medo64/CanStick/Hardware/Board/CanStick-Jack [B].md

### CanStick/Jack ###

Board size: 105.8 x 26.0 mm ~ 4.3 sqin
Panel size: 29.5 x 20.3 mm ~ 1.0 sqin (2x)

#### Input ####

Voltage: 5 V ±10%
Current: 150 mA (max)

#### Parts ####

|  # | Part | RefDes  | Digi-Key Part Number | Alternate Part Number |
|---:|---|---|---|---|
|  2 | C 22pF 16V NP0 (0603) | C1 C2 | 478-1167-1-ND | |
|  1 | C 10nF 16V NP0 (0805) | C3 | 1276-2984-1-ND | |
|  5 | C 100nF 35V X7R (0805) | C4-C8 | 399-1170-1-ND | |
|  4 | C 10uF 16V X5R (0805) | C9-C12  | 399-8013-1-ND | |
|  1 | D PESD1CAN-UX (SOT23-3) | D1 | 568-4032-1-ND | |
|  6 | DS LED (0805) | DS1-DS6 | 475-1415-1-ND | |
|  1 | J USB B, horizontal | J1 | ED2982-ND | |
|  1 | J RJ-45 (56) LED | J2 | RJHSE-5381-ND | |
|  1 | L Ferrite 40Ohm (0805) | L1 | 445-2201-1-ND | |
|  2 | R 120 0.5W (1206) † | R1 R2 | P120ALCT-ND | |
|  5 | R 330 0.125W (0805) | R3-R7 | RMCF0805FT330RCT-ND | |
|  3 | R 1K 0.125W (0805) | R8-R10  | RMCF0805FT1K00CT-ND | |
|  1 | U FT232RL (SSOP-28) | U1 | 768-1007-1-ND | |
|  1 | U PIC18F25K80 (SSOP-28) | U2 | PIC18F25K80-I/SS-ND | |
|  1 | U ISO1050 (SOP-8) | U3 | 296-24818-1-ND | |
|  1 | VR DC-DC 5V->5V 1W (SIP-4) | VR1 | 945-1655-5-ND | |
|  1 | Y Crystal 12MHz 50ppm 20pF | Y1 | 887-2011-ND | 887-1238-ND |
|  1 | H Enclosure 1593DBK | | HM861-ND | |

† Optional termination resistor
