medo64/CanStick/(list of files, drawings)

Other design files:
Hardware/Board/CanStick [B] PanelBack.dip
Hardware/Board/CanStick [B] PanelFront.dip
Hardware/Board/CanStick [B].dip
Hardware/Board/CanStick-Jack [B] PanelBack.dip
Hardware/Board/CanStick-Jack [B] PanelFront.dip
Hardware/Board/CanStick-Jack [B].dip
Hardware/Board/CanStick-Mini [C].dip
