medo64/CanStick/Firmware/Source/config.h

#ifndef CONFIG_H
#define CONFIG_H

#if defined(CANSTICK) == defined(DEVICE_CANJACK)
    #error Must select either CanStick or CanJack device configuration.
#endif


#define _XTAL_FREQ 48000000

void init(void);
void wait_short(void);
void reset(void);

#endif
