medo64/CanStick/(commit log)

2014-03-24 Initial commit.
    [UsbCan [A].dip]
2014-04-09 Refactoring to have all components on top.
    [UsbCan [A].dip]
2014-04-14 Added UART LED.
    [UsbCan [A].dip]
2014-04-14 Added test points.
    [UsbCan [A].dip]
2014-04-14 Added USB power test pads.
    [UsbCan [A].dip]
2014-04-17 Moving U2 label.
    [UsbCan [A].dip]
2014-04-19 Added two more test points.
    [UsbCan [A].dip]
2014-04-19 Renamed project to CanStick.
    [CanStick [A].dip, UsbCan [A].dip]
2014-04-19 Rotated test pads.
    [CanStick [A].dip]
2014-04-30 Changing capacitor type.
2014-05-01 Initial firmware (CAN is not working yet).
    [app.c, config.c, config.h, uart.c, uart.h]
2014-05-01 Changing silk screen.
    [CanStick [A].dip]
2014-05-02 Fixed pull-up MOSFET error.
    [CanStick [A].dip]
2014-05-13 Connected STBY to GND.
    [CanStick [A].dip]
2014-05-13 Initial working CAN TX.
    [SpeedCalc.xlsx]
2014-05-14 Updated formulas.
    [SpeedCalc.xlsx]
2014-05-15 Refactoring so that FTDI can use same crystal as PIC.
    [CanStick [A].dip]
2014-05-16 Adding length into calculations.
    [CanBusSpeed.xlsx, SpeedCalc.xlsx]
2014-05-16 Added oscillator tolerance.
    [CanBusSpeed.xlsx]
2014-05-18 Added diode to prevent CAN voltage keeping device on.
    [CanStick [A].dip]
2014-05-18 Added RTS/CTS data lines.
    [CanStick [A].dip]
2014-05-18 Refactoring UART code.
2014-05-18 Return alone doesn't cause error.
    [app.c]
2014-05-18 Added CAN status command and code doesn't block if CAN TX is passive/off.
    [app.c, can.h]
2014-05-22 Refactoring and changing dim resistors a bit.
    [CanStick [A].dip]
2014-06-14 Updating for adjusted HW design.
    [CanBusSpeed.xlsx]
2014-06-15 Updated silk screen.
    [CanStick [A].dip]
2014-07-03 Changed diode to Shottky.
    [CanStick [A].dip]
2014-11-02 Replaced FT232R with MCP2221.
    [CanStick [A].dip, CanStick [B].dip]
2014-11-02 Filled copper pours.
    [CanStick [B].dip]
2014-11-12 Changed capacitor to cheaper model.
2015-05-27 Added CanJack board.
    [CanJack PanelBack [A].dip, CanJack PanelFront [A].dip, CanJack [A].dip, CanStick [B].dip]
2015-06-07 Corrected resistor DigiKey code.
2015-11-06 Initial commit of CanBlock.
    [CanBlock PanelBack [A].dip, CanBlock PanelFront [A].dip, CanBlock [A].dip]
2016-05-16 Refactoring board.
    [CanBlock PanelBack [A].dip, CanBlock PanelFront [A].dip, CanBlock [A].dip, CanJack PanelBack [A].dip, CanJack PanelFront [A].dip, CanJack [A].dip, CanStick [B] PanelBack.dip, CanStick [B] PanelFront.dip]
2016-05-27 Fixed D1 silk screen.
    [CanStick [B].dip, CanStick-Jack [B].dip]
2016-05-28 Using RA3 to distinguish between CanStick and CanStick/jack.
    [CanStick [B].dip, CanStick-Jack [B].dip, CanStick-Mini [C].dip]
2016-06-06 Added SLCAN support.
    [CanBusSpeed.xlsx]
2016-06-06 Routed shield wire.
    [CanStick-Jack [B].dip]
2016-06-06 Moved activity light to RJ45 connector.
    [CanStick-Jack [B].dip]
2016-07-03 Fixed CAN bus timings.
    [CanBusSpeed.xlsx]
2016-07-04 Adjusting default speeds.
    [CanBusSpeed.xlsx]
2016-07-04 Refactoring and removing unsupported speed (due to high frequency clock).
    [CanBusSpeed.xlsx]
2017-05-28 Changed bear icon.
    [CanStick [B].dip, CanStick-Jack [B].dip, CanStick-Mini [C].dip]
2017-06-03 Changed icon.
    [CanStick [B].dip, CanStick-Jack [B].dip, CanStick-Mini [C].dip]
